hansgaensbauer/Masterflex-Pump-Controller/multi-pump-controller/multi-pump-controller.ods

MPN | Qty | Reference(s) | Value | Footprint
TMK212BBJ106KG-T | 7 | C1, C2, C3, C4, C5, C6, C7 | 10u | 0805
GCM188R71C104KA37J | 8 | C8, C9, C10, C11, C12, C13, C14, C15 | 100n | 0603
150080VS75000 | 9 | D1, D2, D3, D4, D5, D6, D7, D8, D9 | LED_Small | 0805
L717SDB25POL2R210 | 7 | J1, J2, J3, J4, J5, J6, J7 | DB25_Plug_MountingHoles | Connector_Dsub:DSUB-25_Male_Vertical_P2.77x2.84mm_MountingHoles
E8144-B01321-L | 1 | J8 | USB_B | Connector_USB:USB_B_OST_USB-B1HSxx_Horizontal
~ | 4 | J9, J10, J11, J12 | Conn_01x08 | Connector_PinHeader_2.54mm:PinHeader_2x04_P2.54mm_Vertical
~ | 1 | J13 | Conn_02x03_Odd_Even | Connector_PinHeader_2.54mm:PinHeader_2x03_P2.54mm_Vertical
~ | 7 | R1, R2, R5, R7, R9, R11, R13 | 1k | 0603
~ | 9 | R3, R4, R6, R8, R10, R12, R14, R15, R16 | 2k | 0603
~ | 1 | R17 | 10k | 0603
~ | 1 | TP1 | TestPoint | TestPoint:TestPoint_THTPad_D1.5mm_Drill0.7mm
ATMEGA1280V-8AUR | 1 | U1 | ATmega1280V-8A | Package_QFP:TQFP-100_14x14mm_P0.5mm
TS1851ILT | 7 | U2, U3, U4, U5, U6, U7, U8 | TS1851ILT | Package_TO_SOT_SMD:SOT-23-5
FT232RNL-TUBE | 1 | U9 | FT232RL | Package_SO:SSOP-28_5.3x10.2mm_P0.65mm
ECS-160-20-4X-EM | 1 | Y1 | 16Meg | Crystal:Crystal_HC49-4H_Vertical
~ | 14 |  |  | 6mm+6mm 4-40 Standoff
