hansgaensbauer/Masterflex-Pump-Controller/multi-pump-controller/multi-pump-controller.step

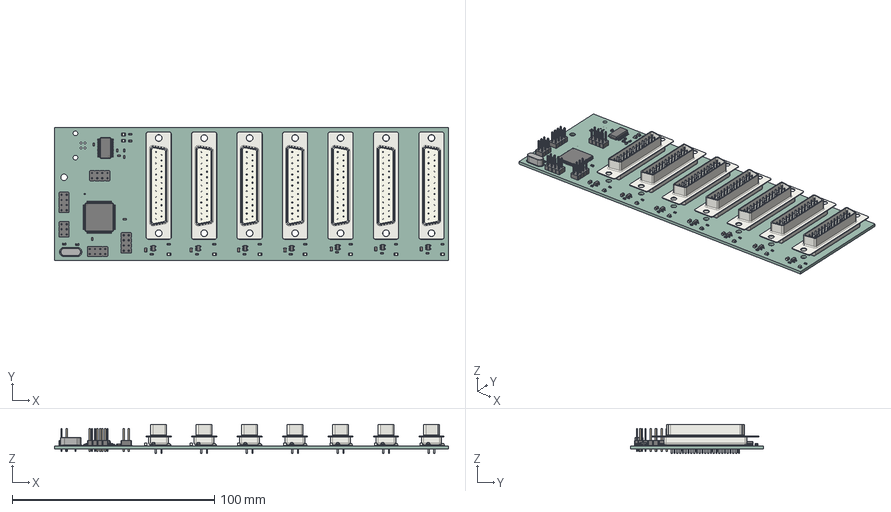
[picture p2: CAD file, 2026-05-23]
multi-pump-controller/multi-pump-controller.step
195.0 x 66.0 x 14.4 mm
multi-pump-controller PCB
