hansgaensbauer/Masterflex-Pump-Controller/multi-pump-controller/multi-pump-controller.kicad_pcb

## KiCad design multi-pump-controller/multi-pump-controller.kicad_pcb (2026-05-23)

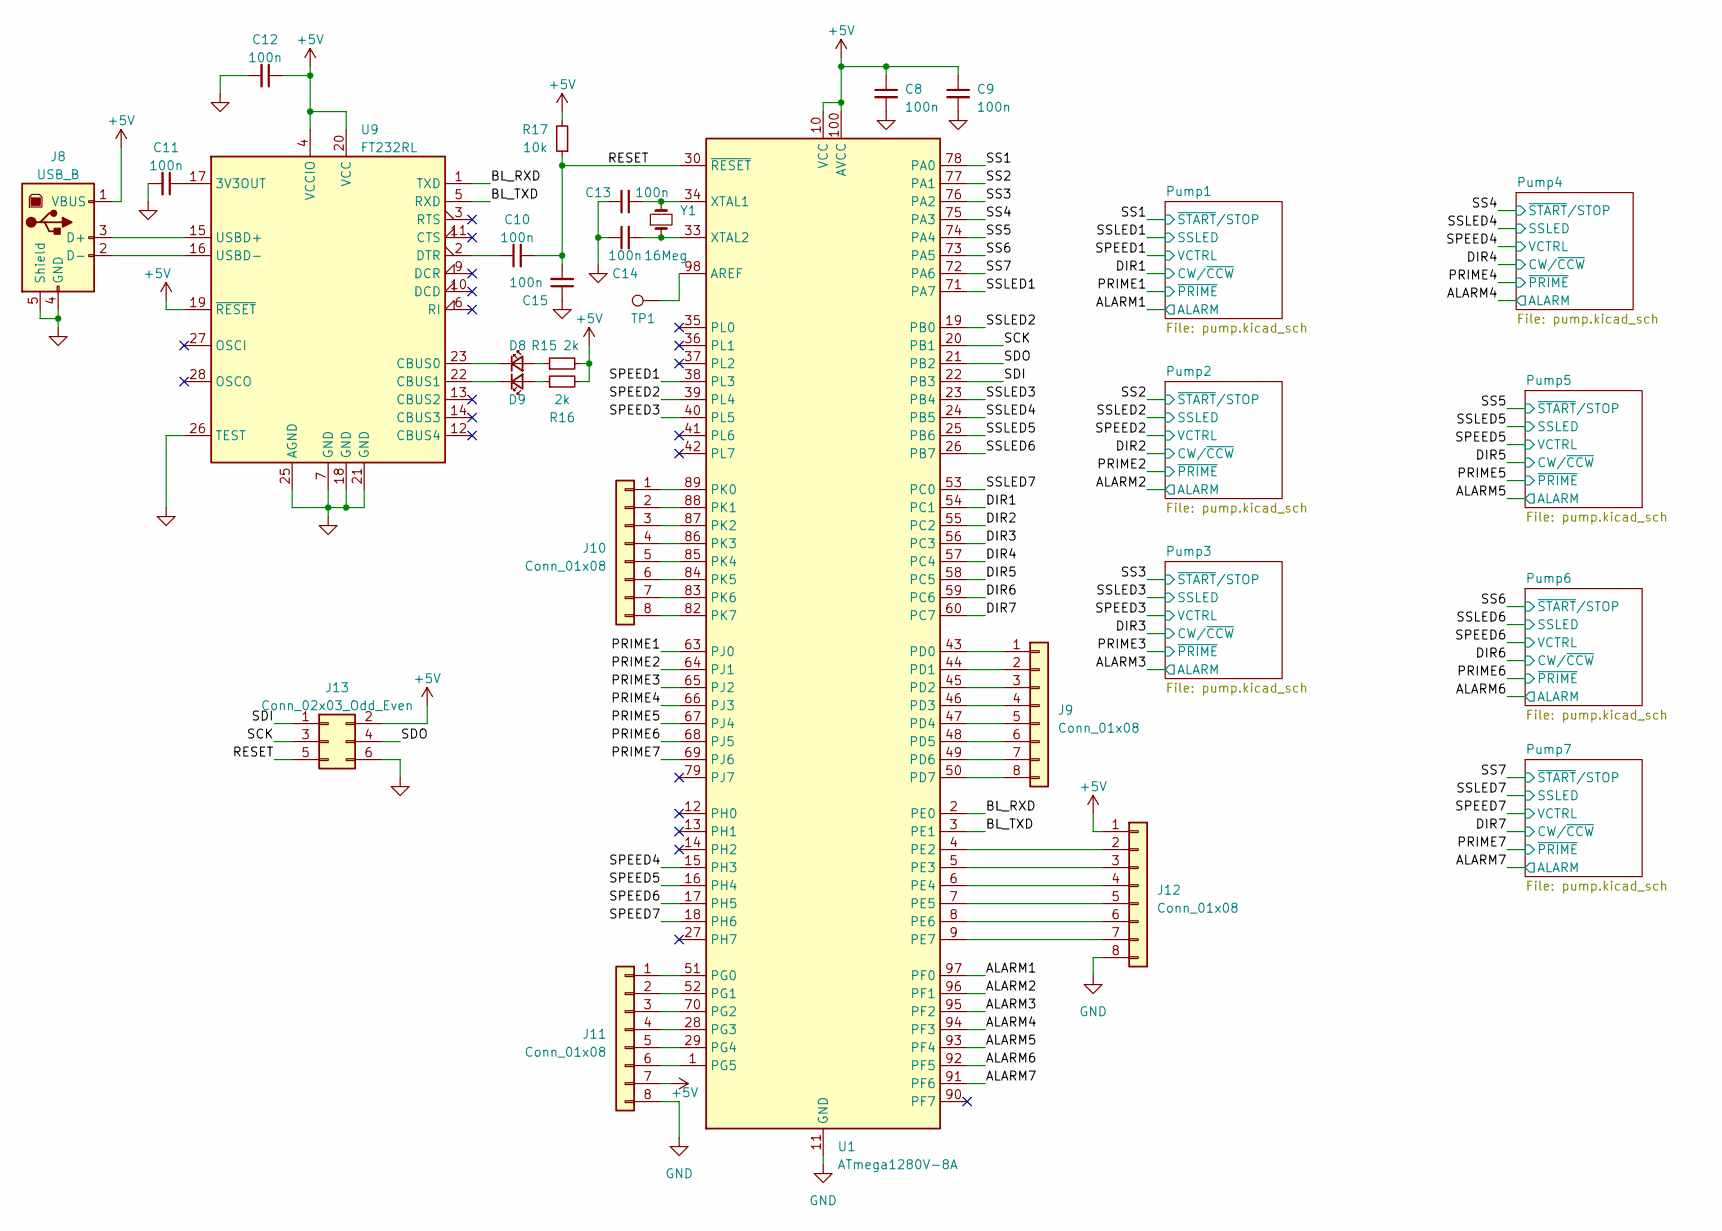
[picture p3: schematic multi-pump-controller.kicad_sch, Multiple Pump Controller]

Parts:
C8, C9, C10, C11, C12, C13, C14, C15: 100n; C_0603_1608Metric
D8, D9: LED_Small; LED_0805_2012Metric
J8: USB_B; USB_B_OST_USB-B1HSxx_Horizontal
J9, J10, J11, J12: Conn_01x08; PinHeader_2x04_P2.54mm_Vertical
J13: Conn_02x03_Odd_Even; PinHeader_2x03_P2.54mm_Vertical
R15, R16: 2k; R_0603_1608Metric
R17: 10k; R_0603_1608Metric
TP1: TestPoint; TestPoint_THTPad_D1.5mm_Drill0.7mm
U1: ATmega1280V-8A; TQFP-100_14x14mm_P0.5mm
U9: FT232RL; SSOP-28_5.3x10.2mm_P0.65mm
Y1: 16Meg; Crystal_HC49-4H_Vertical

Connections:
+5V: C8.1, C9.1, C12.1, J8.1 (VBUS), J11.7, J12.1, J13.2, R15.2, R16.2, R17.2, U1.10 (VCC), U1.31 (VCC), U1.61 (VCC), U1.80 (VCC), U1.100 (AVCC), U9.4 (VCCIO), U9.19 (~RESET), U9.20 (VCC); also elsewhere on the board
/ALARM1: U1.97 (PF0); also elsewhere on the board
/ALARM2: U1.96 (PF1); also elsewhere on the board
/ALARM3: U1.95 (PF2); also elsewhere on the board
/ALARM4: U1.94 (PF3); also elsewhere on the board
/ALARM5: U1.93 (PF4); also elsewhere on the board
/ALARM6: U1.92 (PF5); also elsewhere on the board
/ALARM7: U1.91 (PF6); also elsewhere on the board
/BL_RXD: U1.2 (PE0), U9.1 (TXD)
/BL_TXD: U1.3 (PE1), U9.5 (RXD)
/DIR1: U1.54 (PC1); also elsewhere on the board
/DIR2: U1.55 (PC2); also elsewhere on the board
/DIR3: U1.56 (PC3); also elsewhere on the board
/DIR4: U1.57 (PC4); also elsewhere on the board
/DIR5: U1.58 (PC5); also elsewhere on the board
/DIR6: U1.59 (PC6); also elsewhere on the board
/DIR7: U1.60 (PC7); also elsewhere on the board
/PRIME1: U1.63 (PJ0); also elsewhere on the board
/PRIME2: U1.64 (PJ1); also elsewhere on the board
/PRIME3: U1.65 (PJ2); also elsewhere on the board
/PRIME4: U1.66 (PJ3); also elsewhere on the board
/PRIME5: U1.67 (PJ4); also elsewhere on the board
/PRIME6: U1.68 (PJ5); also elsewhere on the board
/PRIME7: U1.69 (PJ6); also elsewhere on the board
/RESET: C10.2, C15.2, J13.5, R17.1, U1.30 (~RESET)
/SCK: J13.3, U1.20 (PB1)
/SDI: J13.1, U1.22 (PB3)
/SDO: J13.4, U1.21 (PB2)
/SPEED1: U1.38 (PL3); also elsewhere on the board
/SPEED2: U1.39 (PL4); also elsewhere on the board
/SPEED3: U1.40 (PL5); also elsewhere on the board
/SPEED4: U1.15 (PH3); also elsewhere on the board
/SPEED5: U1.16 (PH4); also elsewhere on the board
/SPEED6: U1.17 (PH5); also elsewhere on the board
/SPEED7: U1.18 (PH6); also elsewhere on the board
/SS1: U1.78 (PA0); also elsewhere on the board
/SS2: U1.77 (PA1); also elsewhere on the board
/SS3: U1.76 (PA2); also elsewhere on the board
/SS4: U1.75 (PA3); also elsewhere on the board
/SS5: U1.74 (PA4); also elsewhere on the board
/SS6: U1.73 (PA5); also elsewhere on the board
/SS7: U1.72 (PA6); also elsewhere on the board
/SSLED1: U1.71 (PA7); also elsewhere on the board
/SSLED2: U1.19 (PB0); also elsewhere on the board
/SSLED3: U1.23 (PB4); also elsewhere on the board
/SSLED4: U1.24 (PB5); also elsewhere on the board
/SSLED5: U1.25 (PB6); also elsewhere on the board
/SSLED6: U1.26 (PB7); also elsewhere on the board
/SSLED7: U1.53 (PC0); also elsewhere on the board
GND: C8.2, C9.2, C11.2, C12.2, C13.1, C14.1, C15.1, J8.4 (GND), J8.5 (Shield), J11.8, J12.8, J13.6, U1.11 (GND), U1.32 (GND), U1.62 (GND), U1.81 (GND), U1.99 (GND), U9.7 (GND), U9.18 (GND), U9.21 (GND), U9.25 (AGND), U9.26 (TEST); also elsewhere on the board
unnamed: D8.2 (A), R15.1
unnamed: D8.1 (K), U9.23 (CBUS0)
unnamed: D9.2 (A), R16.1
unnamed: D9.1 (K), U9.22 (CBUS1)
unnamed: J8.3 (D+), U9.15 (USBD+)
unnamed: J8.2 (D-), U9.16 (USBD-)
unnamed: J9.1, U1.43 (PD0)
unnamed: J9.2, U1.44 (PD1)
unnamed: J9.3, U1.45 (PD2)
unnamed: J9.4, U1.46 (PD3)
unnamed: J9.5, U1.47 (PD4)
unnamed: J9.6, U1.48 (PD5)
unnamed: J9.7, U1.49 (PD6)
unnamed: J9.8, U1.50 (PD7)
unnamed: J10.1, U1.89 (PK0)
unnamed: J10.2, U1.88 (PK1)
unnamed: J10.3, U1.87 (PK2)
unnamed: J10.4, U1.86 (PK3)
unnamed: J10.5, U1.85 (PK4)
unnamed: J10.6, U1.84 (PK5)
unnamed: J10.7, U1.83 (PK6)
unnamed: J10.8, U1.82 (PK7)
unnamed: J11.1, U1.51 (PG0)
unnamed: J11.2, U1.52 (PG1)
unnamed: J11.3, U1.70 (PG2)
unnamed: J11.4, U1.28 (PG3)
unnamed: J11.5, U1.29 (PG4)
unnamed: J11.6, U1.1 (PG5)
unnamed: J12.2, U1.4 (PE2)
unnamed: J12.3, U1.5 (PE3)
unnamed: J12.4, U1.6 (PE4)
unnamed: J12.5, U1.7 (PE5)
unnamed: J12.6, U1.8 (PE6)
unnamed: J12.7, U1.9 (PE7)
unnamed: TP1.1, U1.98 (AREF)
unnamed: C13.2, U1.34 (XTAL1), Y1.2
unnamed: C14.2, U1.33 (XTAL2), Y1.1
unnamed: C11.1, U9.17 (3V3OUT)
unnamed: C10.1, U9.2 (DTR)

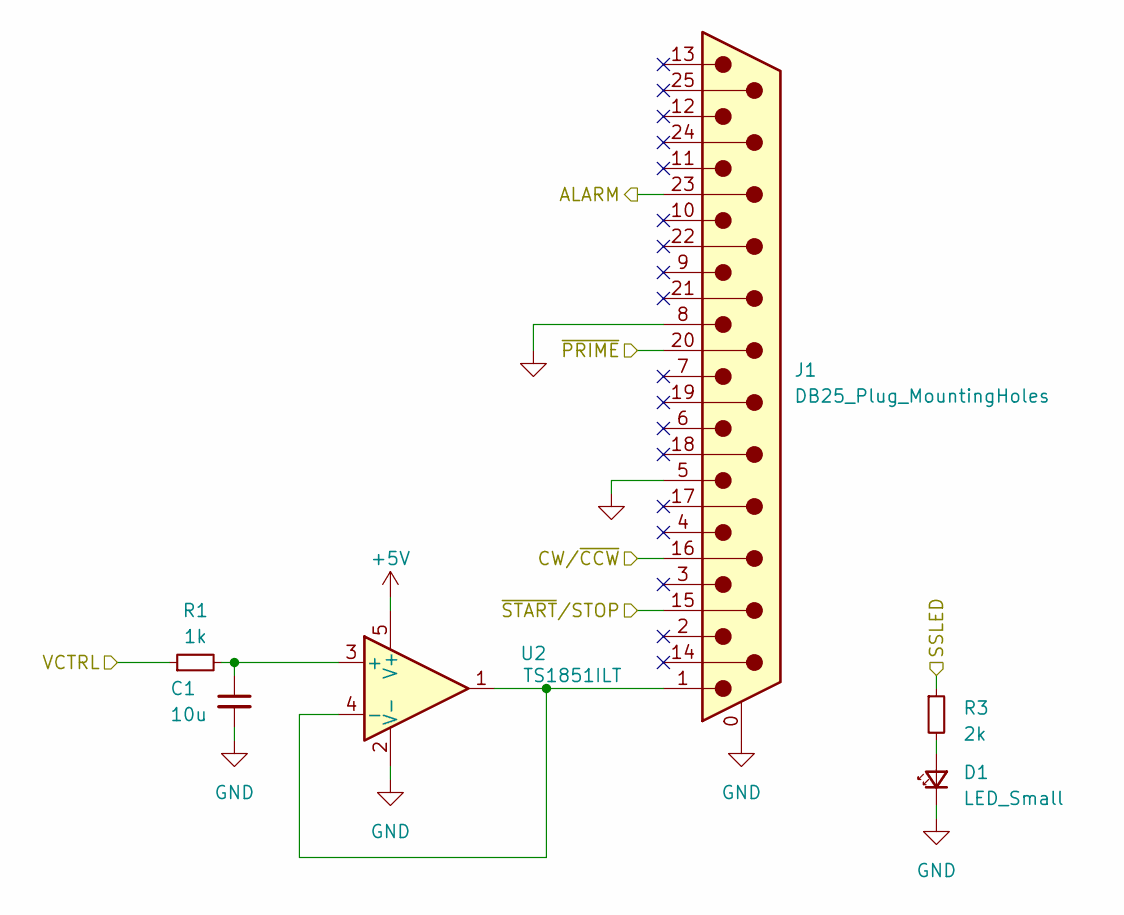
[picture p4: schematic pump.kicad_sch]

Parts:
C1: 10u; C_0805_2012Metric
D1: LED_Small; LED_0805_2012Metric
J1: DB25_Plug_MountingHoles; DSUB-25_Male_Vertical_P2.77x2.84mm_MountingHoles
R1: 1k; R_0603_1608Metric
R3: 2k; R_0603_1608Metric
U2: TS1851ILT; SOT-23-5

Connections:
+5V: U2.5 (V+); also elsewhere on the board
/ALARM1: J1.23; also elsewhere on the board
/DIR1: J1.16; also elsewhere on the board
/PRIME1: J1.20; also elsewhere on the board
/SPEED1: R1.1; also elsewhere on the board
/SS1: J1.15; also elsewhere on the board
/SSLED1: R3.1; also elsewhere on the board
GND: C1.2, D1.1 (K), J1.0 (PAD), J1.5, J1.8, U2.2 (V-); also elsewhere on the board
unnamed: D1.2 (A), R3.2
unnamed: C1.1, R1.2, U2.3 (+)
unnamed: J1.1, U2.1, U2.4 (-)

Parts of its further copies:
C2, C3, C4, C5, C6, C7: 10u; C_0805_2012Metric
D2, D3, D4, D5, D6, D7: LED_Small; LED_0805_2012Metric
J2, J3, J4, J5, J6, J7: DB25_Plug_MountingHoles; DSUB-25_Male_Vertical_P2.77x2.84mm_MountingHoles
R2, R5, R7, R9, R11, R13: 1k; R_0603_1608Metric
R4, R6, R8, R10, R12, R14: 2k; R_0603_1608Metric
U3, U4, U5, U6, U7, U8: TS1851ILT; SOT-23-5

Connections of its further copies:
+5V: U3.5 (V+), U4.5 (V+), U5.5 (V+), U6.5 (V+), U7.5 (V+), U8.5 (V+); also elsewhere on the board
/ALARM2: J2.23; also elsewhere on the board
/ALARM3: J3.23; also elsewhere on the board
/ALARM4: J4.23; also elsewhere on the board
/ALARM5: J5.23; also elsewhere on the board
/ALARM6: J6.23; also elsewhere on the board
/ALARM7: J7.23; also elsewhere on the board
/DIR2: J2.16; also elsewhere on the board
/DIR3: J3.16; also elsewhere on the board
/DIR4: J4.16; also elsewhere on the board
/DIR5: J5.16; also elsewhere on the board
/DIR6: J6.16; also elsewhere on the board
/DIR7: J7.16; also elsewhere on the board
/PRIME2: J2.20; also elsewhere on the board
/PRIME3: J3.20; also elsewhere on the board
/PRIME4: J4.20; also elsewhere on the board
/PRIME5: J5.20; also elsewhere on the board
/PRIME6: J6.20; also elsewhere on the board
/PRIME7: J7.20; also elsewhere on the board
/SPEED2: R2.1; also elsewhere on the board
/SPEED3: R5.1; also elsewhere on the board
/SPEED4: R7.1; also elsewhere on the board
/SPEED5: R9.1; also elsewhere on the board
/SPEED6: R11.1; also elsewhere on the board
/SPEED7: R13.1; also elsewhere on the board
/SS2: J2.15; also elsewhere on the board
/SS3: J3.15; also elsewhere on the board
/SS4: J4.15; also elsewhere on the board
/SS5: J5.15; also elsewhere on the board
/SS6: J6.15; also elsewhere on the board
/SS7: J7.15; also elsewhere on the board
/SSLED2: R4.1; also elsewhere on the board
/SSLED3: R6.1; also elsewhere on the board
/SSLED4: R8.1; also elsewhere on the board
/SSLED5: R10.1; also elsewhere on the board
/SSLED6: R12.1; also elsewhere on the board
/SSLED7: R14.1; also elsewhere on the board
GND: C2.2, C3.2, C4.2, C5.2, C6.2, C7.2, D2.1 (K), D3.1 (K), D4.1 (K), D5.1 (K), D6.1 (K), D7.1 (K), J2.0 (PAD), J2.5, J2.8, J3.0 (PAD), J3.5, J3.8, J4.0 (PAD), J4.5, J4.8, J5.0 (PAD), J5.5, J5.8, J6.0 (PAD), J6.5, J6.8, J7.0 (PAD), J7.5, J7.8, U3.2 (V-), U4.2 (V-), U5.2 (V-), U6.2 (V-), U7.2 (V-), U8.2 (V-); also elsewhere on the board
unnamed: D2.2 (A), R4.2
unnamed: D3.2 (A), R6.2
unnamed: D4.2 (A), R8.2
unnamed: D5.2 (A), R10.2
unnamed: D6.2 (A), R12.2
unnamed: D7.2 (A), R14.2
unnamed: C2.1, R2.2, U3.3 (+)
unnamed: J2.1, U3.1, U3.4 (-)
unnamed: C3.1, R5.2, U4.3 (+)
unnamed: J3.1, U4.1, U4.4 (-)
unnamed: C4.1, R7.2, U5.3 (+)
unnamed: J4.1, U5.1, U5.4 (-)
unnamed: C5.1, R9.2, U6.3 (+)
unnamed: J5.1, U6.1, U6.4 (-)
unnamed: C6.1, R11.2, U7.3 (+)
unnamed: J6.1, U7.1, U7.4 (-)
unnamed: C7.1, R13.2, U8.3 (+)
unnamed: J7.1, U8.1, U8.4 (-)

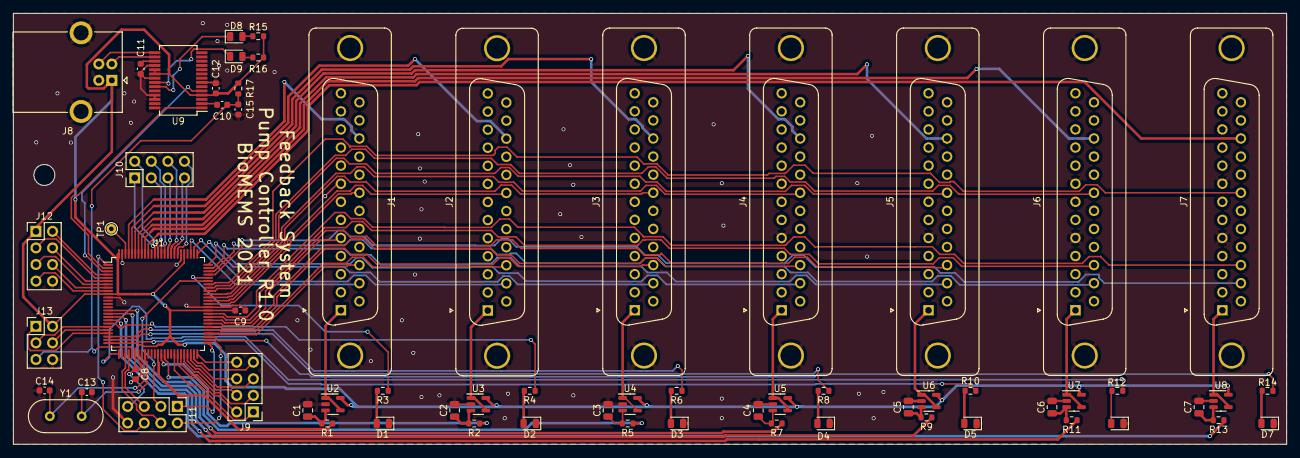
[picture p5: board multi-pump-controller.kicad_pcb from above]

Board: 2 copper layers, 195.0 x 66.0 mm, 65 parts (0 on the bottom side), 110 nets.
